Sarrus/Beltrak/README.md

Beltrak
=======

Hornby trainset automation.

My first ever sizable coding project.

Controls a Hornby trainset. Might be useful in a somewhat bizarre set of circumstances.
