Sarrus/Beltrak/the missing page.docx

| GCE Computing

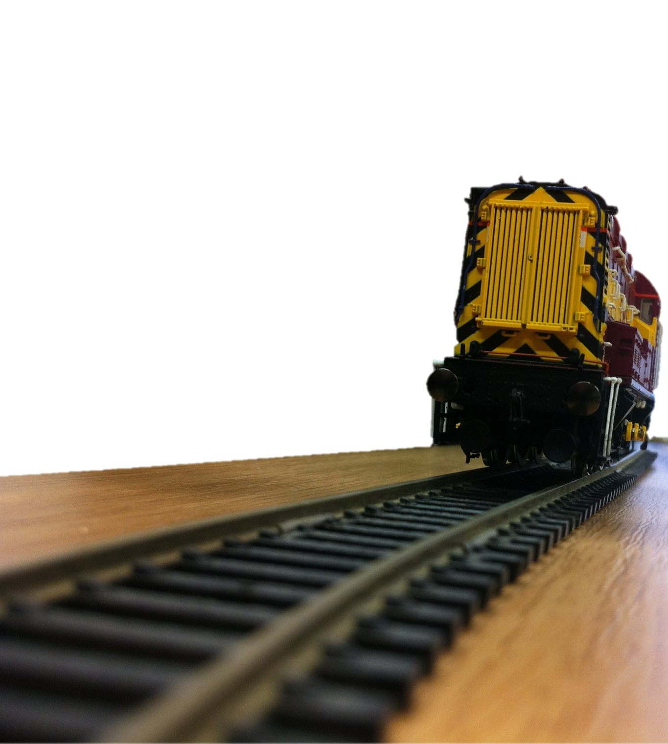
[picture p7: figure]

| Doverbroeck’s Colage 62315 Michael R. Bell 7894

[Beltrac]

Model railway automation.

# Evaluation of the User’s Response to the system

Having read the questionnaire on page 107 I am extremely pleased with his response, his smiley faces and his adding out of bounds answers (positively of course) to the amusement section have made me extremely pleased!

From what he has said I can gather that he Is pleased with the project and it amuses him but it could look better.

While the project is finished my next objective would be to improve the aesthetics of the track, possibly by recruiting the help of someone with taste.

BeltracMichael Bell111/113
