Sarrus/Beltrak/project writeup backups/Project writeup backup 1.docx

| GCE Computing


| Doverbroeck’s Colage 62315 Michael R. Bell 7894

[Beltrac]

Model railway automation.

# definition, investigation and Analasis

# Definition – nature of the problem to be investigated

## the end user

The project is being produced for John Peter Thomas, the owner of a small computer company. In his own words, this is a brief description of his company:

The company is a lifestyle company, i.e. we keep it relatively small, we enjoy our work and we're driven more by the quality of the work we're offered rather than the money. That said, we've recently grown a little to 10 developers who work on a range of bespoke projects for a wide variety of clients. We started out writing code for embedded systems, but have more recently specialised in code for web applications and mobile platforms. We've written primarily for the iPhone, but more recently we've been looking at Android apps. On occasion we are asked to develop full blown web sites, though we have tried to stay away from these as much as possible. We've recently employed a graphics designer for the first time and will most likely take on more web based projects as time moves on.

We've taken on projects for students from d'Overbroecks in the past and without exception have been really pleased with the results. I'm looking forward to seeing a preliminary requirements specification soon.

## the problem

Mr Thomas has a lobby where people wait before meeting him, as this would be where potential clients would find themselves waiting for meetings with him and his staff it would be good to have something to entertain potential clients while they wait, which at the moment they don’t have.

Providing something interesting to entertain has several advantages:

- It prevents potential clients from getting bored and so keeps their mood light for the meeting ahead which can increase the chances of success
- It can display what the company is capable of or, if not created by the company, can imply an ability to produce similar things or an interest in the particular subject matter. Again, this can increase the chances of a deal being struck as well as providing ideas for alternative products

## resources provided

In terms of what Mr. Thomas is willing to provide me it would really just be some floor space and a power supply to use, being England this would be 230~240V(rms) at 50Hz

## further steps

Having gathered a bit of information I arranged a meeting with Mr Thomas, in conversation I asked him some questions about the project, I noted down some basic points based on the responses to the questions:

- We decided to call the project Beltrac
- Beltrak will be on a static platform (no wheels)
- Beltrak will be a loop
- Beltrak will have a cleaning train which dusts the track when switched on
- Beltrak will have a standard train which can be controlled
- Beltrak will have a small display with a simple menu system
- Beltrak will have automated points that can change to navigate the trainto its destination
- Beltrak will have sensors on the track to detect the location of the train
- Beltrak will have an integrated cuircuit breaker to protect the train from surges and from the control board supplying to much current
- Beltrak will have an easy to use interface that requires no pre instruction (though a manual will be provided

Of course, this alone is not enough to create a requirement specification but the information discussed is a good start as well as an opertunity to get to know Mr Thomas a bit better.

# Investigation and analysis

## asertaining the user requirements

### Talking to the user

To begin the whole project process I began by emailing mr. Thomas with a brief explanation of what I am looking to do:

Dear MR Thomas,

I am an A-level student looking to produce a computing project, I am aware that this may not be the first time you have received a request like this, as my teacher Alan informs me that you often act as a client for projects, despite this I hope you will be willing to review my proposal as I am confident in its merit, particularly to someone with such a vast appreciation of complicated electronic nick-nacks.

Did you ever play with Hornby or some other brand of model railway as a kid? Because I sure did! It was a good, carefree time in my life. my proposal is there for an attempt to revive the former, stress relieving, glory by attempting to attach the subtle science of railway signalling to something on a smaller scale by creating a railway that would be safe enough to automatically carry passengers from A to B with minimal loss of limbs.

In principal it would be a similar model to that of the docklands light railway, that is, a train controlled by a computer off the train, using data gathered from the tracks about the location of the train and other obstacles, with the advantage of not actually carrying passengers which eliminates the necessity for a member of railway staff on hand to unjam passengers from the doors (of course the dispatch panel on board the train could be simulated externally for the full experience).

you are probably wandering what this project could possibly do for you but picture this, the world industry is changing, for all you know your company may go into "railway related work" someday and it would certainly be swell to have a fully automated model railway to entertain waiting clients

Should you have any questions I would be happy to indulge them,

Michael Bell

His 1st reply was:

Hello Michael

Alan did tell me that you had a project that you'd like to do. As Alan probably told you we do like to display interesting projects in our entrance area and I've been very happy to showcase student projects before so your project definitely does interest me. A working train set in the office would definitely draw some interest especially if it has a significant control component.

What sort of control hardware do you have in mind? There's a lot of buzz these days about the Raspberry Pi which is an excellent piece of kit but I suspect that you should consider something more dedicated to control such as the Arduino range of boards. They're programmable in C and have a wide range of analog and digital inputs and outputs.

Alan has asked me to look at one of his other students' projects this year too - perhaps the two of you could get together and come down to meet us some time in the next week or so.

Cheers

-John

After this we began an exchange in which I sent mr. Thomas a series of questions and he replied with answers to each question, though not the original format, for readability I have separated out each question and the responses given to it. My questions / responses are written in Lilac and mr thomas’s are written in brown,

- Would you like an interface to control the train and if so what would be your preference on what it is? LCD, computer program etc.
  - An LCD interface is fine, how many characters? how many lines? colour or b&w?
    - It would have 2 lines probably about 20 chars each
      - That's fine, but you'll need to specify exactly what's going to appear on each of the lines. I suggest for simplicity that you try to adopt a menu structure, but maybe you have other ideas.
        - No, a menu structure sounds good to me
  - A standard PC computer interface would also be great - you might find it sensible in your development to build a PC interface simply to provide yourself with a simple easy to change interface. Programming LCD displays is often trickier. But, clearly we'll need some sort of user interface in the final version and an LCD interface would be fine, assuming of course that its comprehensive and ideally intuitive. We'd like our visitors to be able to play with it when they're waiting for us and it needs to be self explanatory if that's going to work.
    - The lcd i had in mind is quite easy to program, it is designed specificaly for the arduino board and operating it is as easy as sending it a string of text
      - Sounds good - is it colour?
        - No its just 2 lines of black and white characters
  - Clearly we need to agree on what the user interface is going to allow us to do - that will require quite a bit of discussion.
    - I know you want it to allow selection of a destination, and to initiate the cleaning train, what else would you like it to do?
- The track needs to be cleaned regularly as dust can damage the trains, would you like to clean it yourself or have a second train that cleans the track at regular intervals?
  - A secondary train is an excellent idea. Perhaps it could appear at various intervals ? It would be nice to control this from the user interface, i.e. set intervals, initiate cleaning and so on.
    - Thats fine though i should say that the abrasive pads on the bottom of the train must be changed by hand when they get clogged up with dust
      - OK - that's something that we can organise on a regular basis.
- Would you like the train system to turn itself on and off at set times? Eg. Running only during office hours
  - An automatic mode is an excellent idea - again a variety of scenarios chosen from the user interface would be good.
- Would you like the primary train to (in automatic mode) run itself to a scedual or pick stations at random
  - Both, set by the user interface.
- How many stops would you like?
  - How many can we have ?
    - I would say about 5 would be a good idea
      - OK.
- Would you like the trains to move relitivly quickly or slowly?
  - Various speeds - sometimes fast, sometimes slow, again set by the user interface - scripted would be good.
    - Ok i will
- Would you like electronic signals on the track? Eg. Lights, semaphores etc.
  - Definitely.
  - Can I please see some diagrams of how you're planning on laying out the track? Do you have any photographs? It would be good to get a really good idea of how big and complicated the system is.
    - I will have lots of time to do that this weekend
      - Could I see some please.
        - I will send you some pictures ASAP
  - What are your thoughts on user interface functionality?
    - I think that there should be a manual and automatic mode, the modes could be switched by a switch or a key, in automatic mode the screen displays the name of the prgram on the top line and what the train is currently doing eg. "Awaiting Right Ahead" or "slowing for stop in block 1"
    - In manual mode the program would have a simple menu struture allowing options like, setting what the train does in automatic mode, picking the next station for the train to reach, initiating cleaning, setting on and off times and checking that the track is clear.
    - When in automatic mode, customers could interface with the train using large colourful iluminated buttons rather than a booreing looking lcd display with options like "go" "stop now" "stop at next station" etc.
      - That sounds fine.
  - What are you planning to use as your control hardware? I know that Leo is thinking seriously about using an arduino board - are you going down the same route or do you have some alternatives in mind ?
    - Same route

During this conversation mr Thomas requested some pictures of a basic track layout and the train so I captured these images and sent them to him:

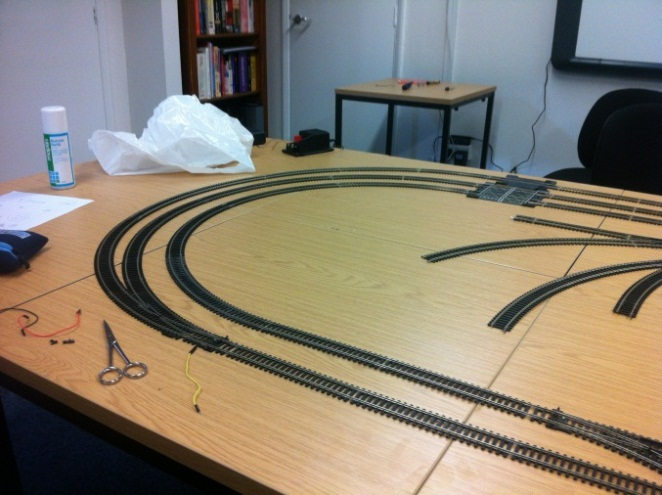
[picture p8: figure]
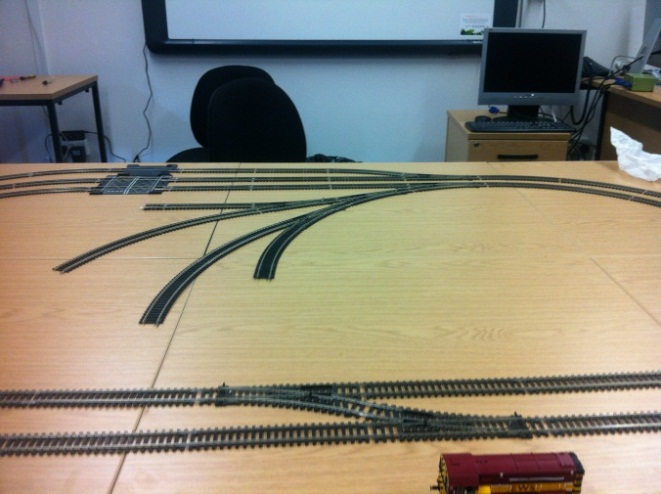
[picture p9: figure]
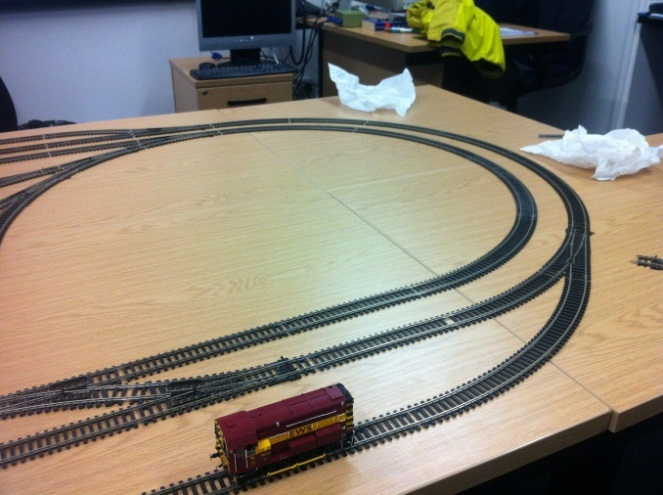
[picture p10: figure]
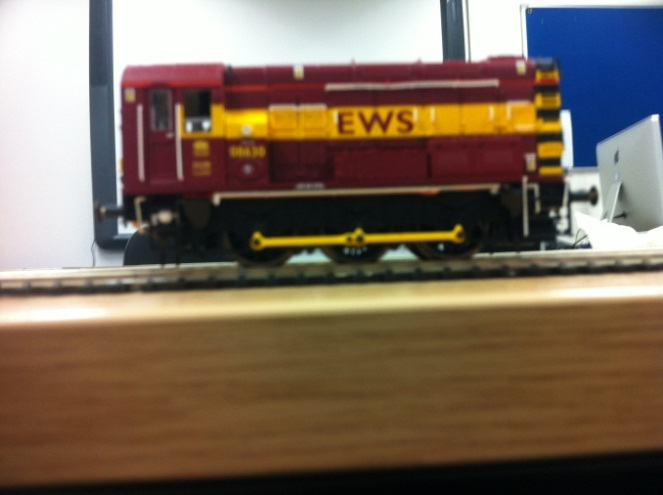
[picture p11: figure]
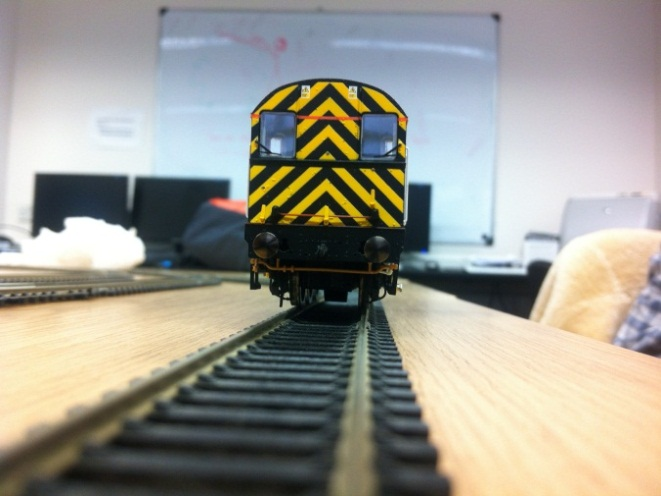
[picture p12: figure]

This was his response:

Thanks for these - I assume that the image of the track is the track you'd like to use. If so, it looks good but I'd like to understand what functionality you are thinking of including. By which I mean things like,

what is the function of the `orphan' pieces in the centre?

how many sensors are you planning on using?

how many points are there in total ? presumably you're intending to control the movement of the train by modifying the position of the points and controlling the speed and the direction of the train - that should do everything you want.

You mentioned a `cleaning' train. Presumably that will sit somewhere off the main track and move out into the central section when required, at which point presumably the train itself will have to move elsewhere - all of which will again presumably be under microprocessor control?

In order to understand exactly what you're proposing, I really would like to see a reasonably complete description of the functionality of the entire operation of the train line. Can you get this to me fairly soon so that we can internally make a final decision on whether the project is interesting enough to take up some of our foyer space.

Thanks

-John

## requirements specification

### 1.0

#### user requirements

1. The user should be able to select a manual or automatic mode
  a. In manual mode the next destination of the train can be chosen
  b. In automatic mode the train goes to either random or sequential stations until stoped
2. The user should be presented with a simple display that can be controlled using directional arrows and a confirm button

#### hardware requirements

1. there should be a small train (00 gague) which is controlled by a microcontroller with the user interfase attached
2. the train should travel at multiple speeds and stop at multiple stations with points used to provide multiple possible routes
3. sensors on the track or the train should detect its location and this information should be used to manuver the train
4. the maximum voltage of the train should never be exceded
5. the train should appear to gain or loose speed smoothly
6. the tracks should be able to isolate a sideing so that the train on it can be held, allowing a different train a turn on the tracks
7. the train should be able to travel forwards and backwards at equal maximum speeds
8. the layout should be designed that if the train is moved forward that no mater where it is it will always trigger a sensor on its journey
9. failsafes such as circuit breakers should be in place to protect the train and the equipment

#### software requirements

1. The microcontroller should be able to recognise the location of the train and act accordingly
2. It should anticipate the possibility that a sensor has failed and should be able to act if the sensors are not called in sequence
3. The software should be able to plot a route from any station to any station
4. The software should be able to activate a cleaning train at any time to clean all the tracks and it should be able to manage the activation of both this and the main train by isolating sidings
5. The software should be able to reacertain the location of the train in case of a power failure by moveing it forward untill it trigures a sensor
6. The software must not perform any actions that could damage the train or any other equipment

BeltracMichael Bell6/9
