Sarrus/Beltrak/foil block.pdf

# BELTRAC

HORNBY TRAIN SET AUTOMATION

Michael Bell
