Sarrus/Beltrak/designs/track design 1 potentialy different isolatable track.png

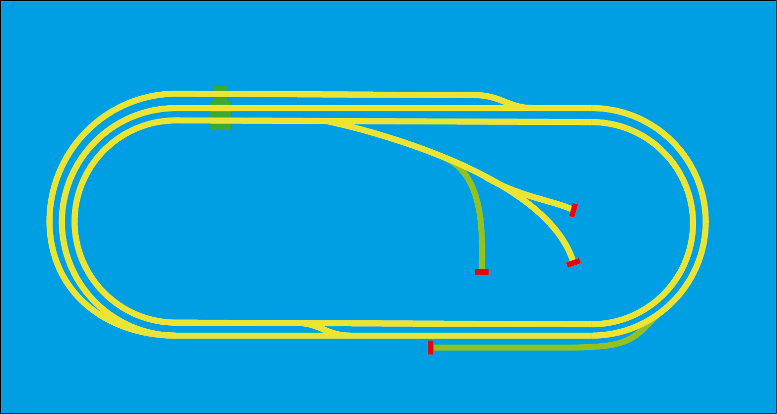
designs/track design 1 potentialy different isolatable track.png
