Sarrus/Beltrak/designs/track design 1 potentialy different with sensors positioned.png

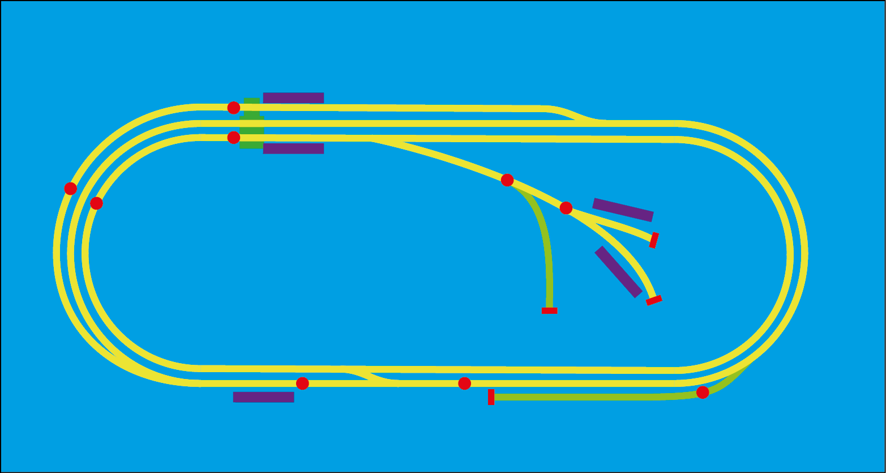
designs/track design 1 potentialy different with sensors positioned.png
