Sarrus/Beltrak/pictures/real world examples/Rail_treadle.jpg

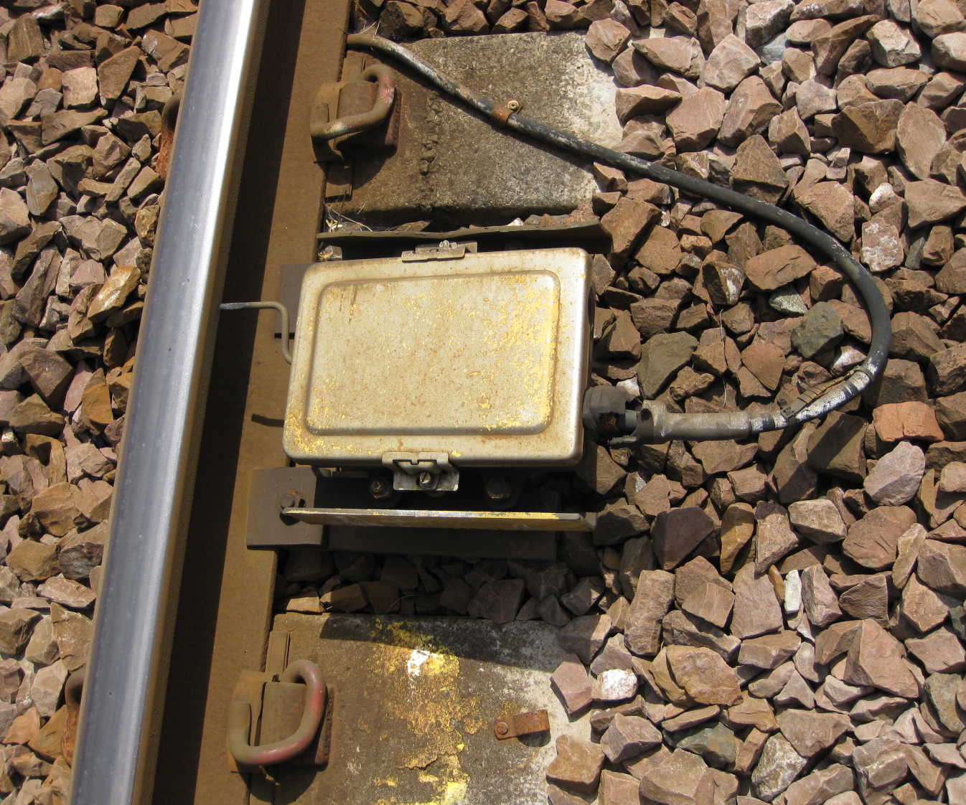
pictures/real world examples/Rail_treadle.jpg
