Sarrus/Beltrak/pictures/tittle pages/4437422182_d478fc9a82_o.jpg

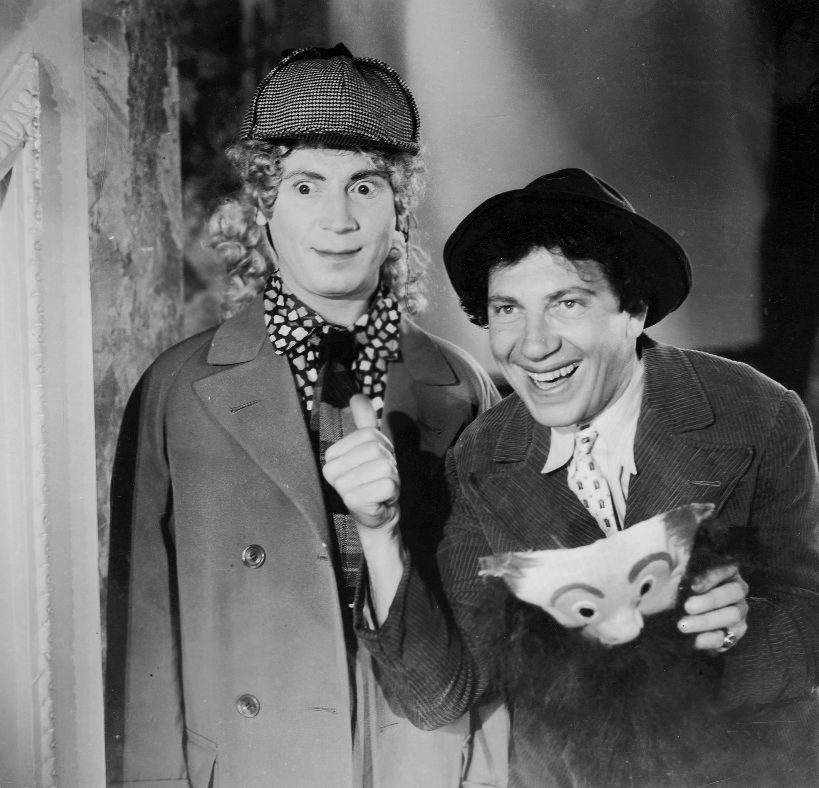
pictures/tittle pages/4437422182_d478fc9a82_o.jpg
