Sarrus/Beltrak/pictures/tittle pages/peter-sellers-trenchcoat.jpg

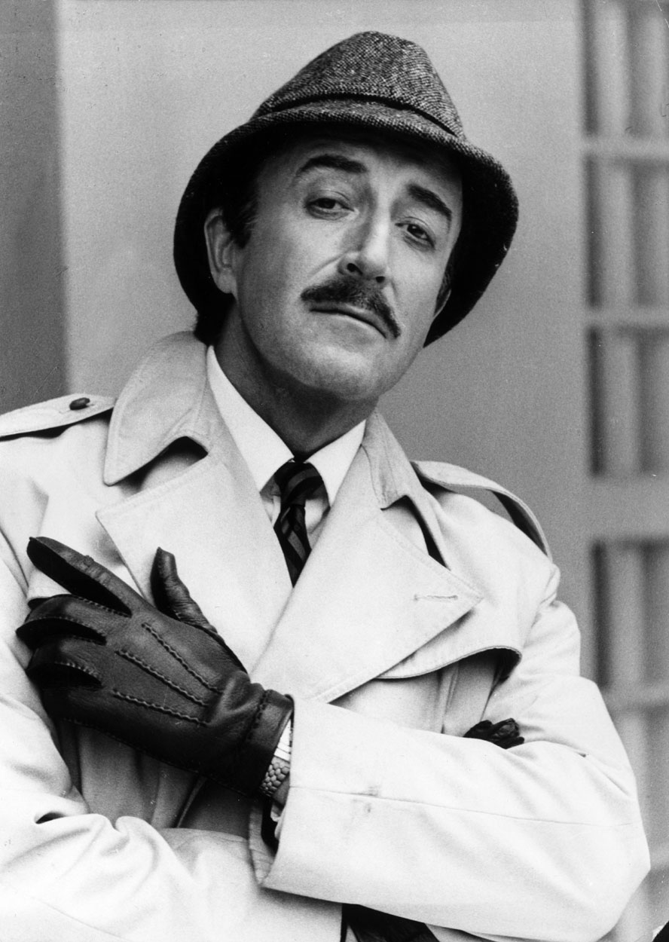
pictures/tittle pages/peter-sellers-trenchcoat.jpg
