Sarrus/Beltrak/pictures/track design/-neodymium-magnet-0.72kg-pull-x25-a28-y--147-p.jpg

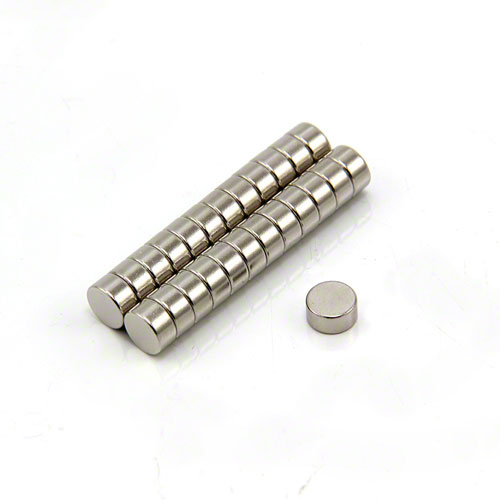
pictures/track design/-neodymium-magnet-0.72kg-pull-x25-a28-y--147-p.jpg
