Sarrus/Beltrak/Requirement specifications/track design 1.png

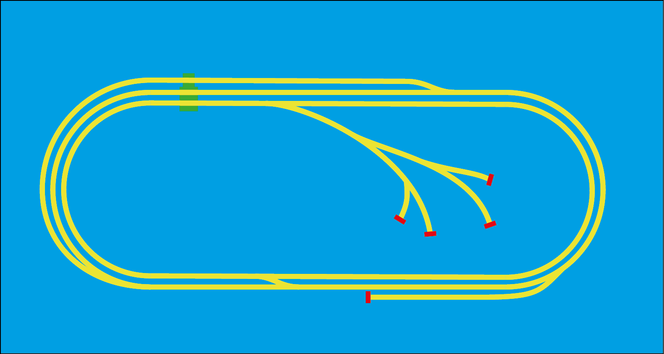
Requirement specifications/track design 1.png
