Sarrus/Beltrak/pictures/hall effect testing/Photo 04-12-2012 10 16 29.jpg

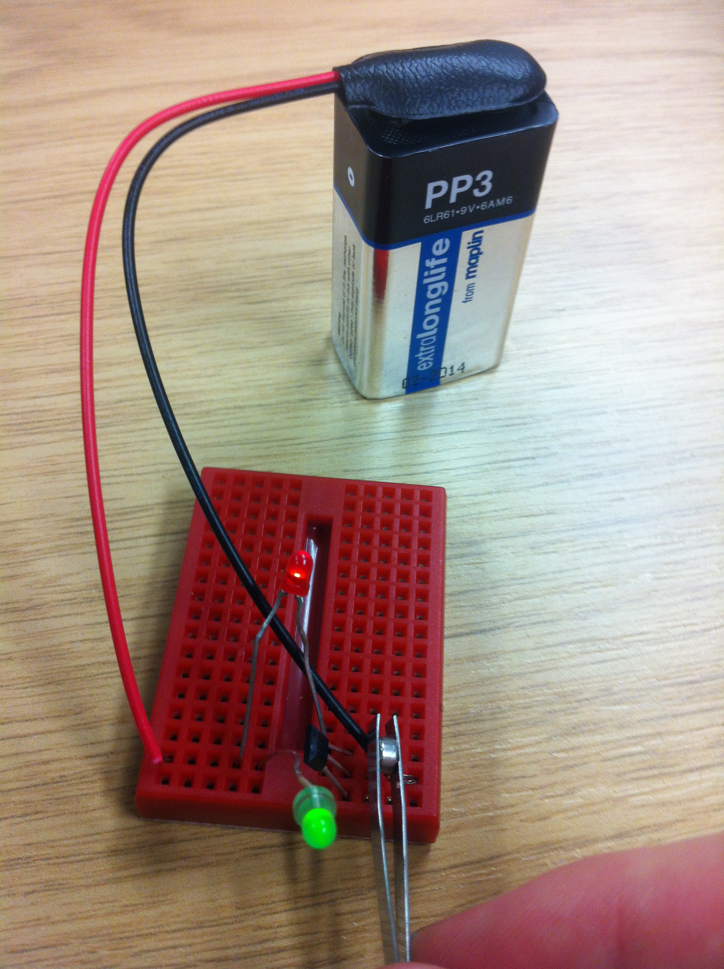
pictures/hall effect testing/Photo 04-12-2012 10 16 29.jpg
