Sarrus/Beltrak/pictures/motor testing/Photo 20-11-2012 10 43 38.jpg

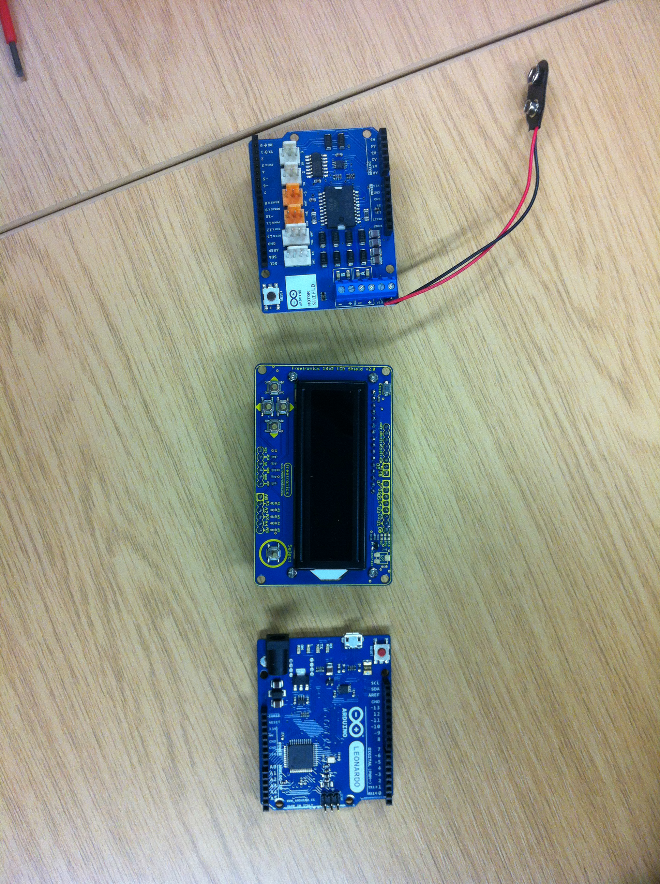
pictures/motor testing/Photo 20-11-2012 10 43 38.jpg
