Sarrus/Beltrak/pictures/motor testing/Photo 20-11-2012 10 45 24.jpg

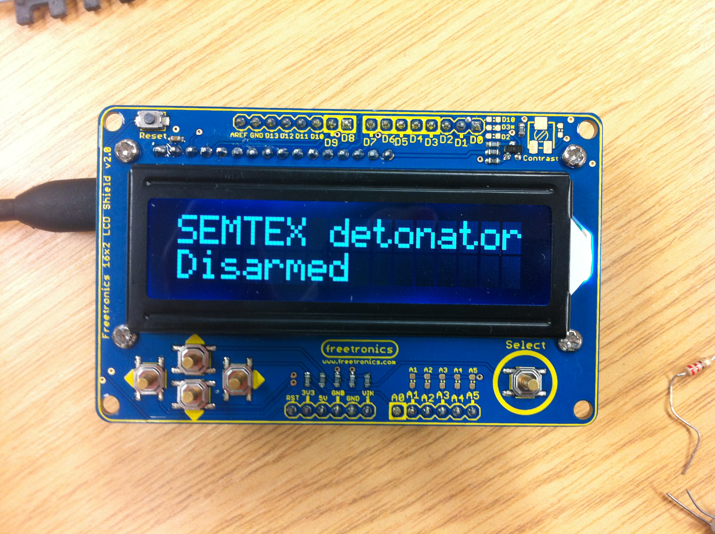
pictures/motor testing/Photo 20-11-2012 10 45 24.jpg
