Sarrus/Beltrak/pictures/motor testing/Photo 20-11-2012 10 46 00.jpg

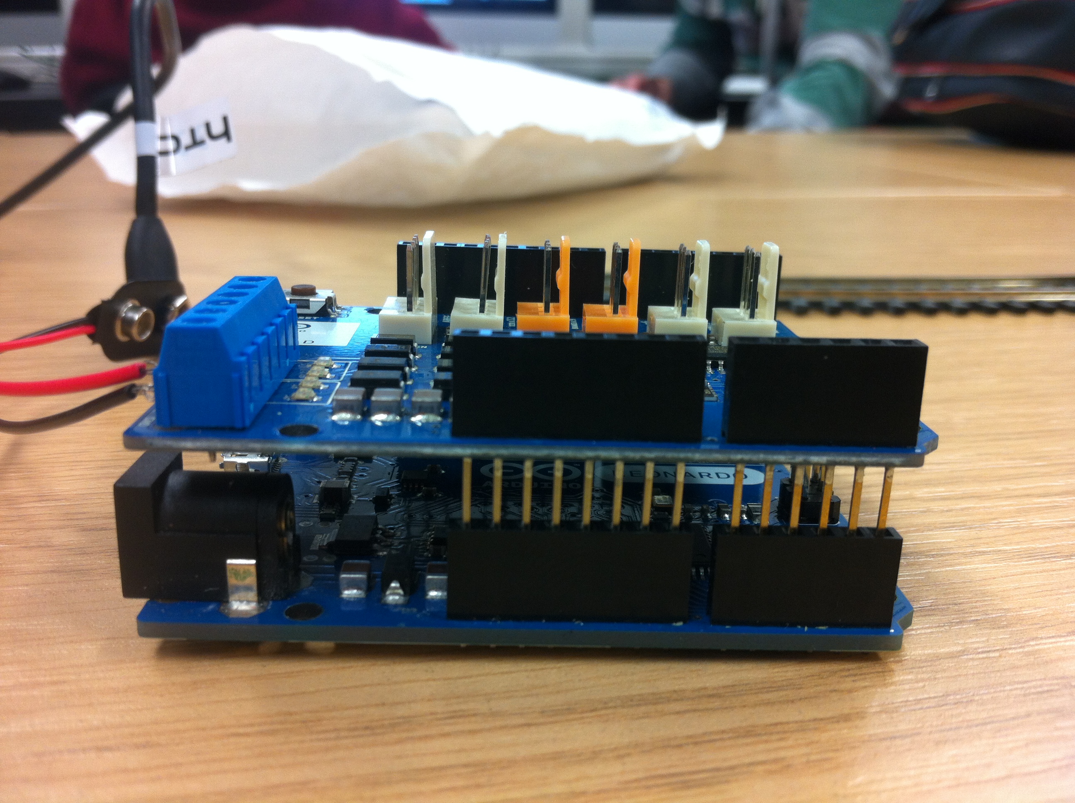
pictures/motor testing/Photo 20-11-2012 10 46 00.jpg
