Sarrus/Beltrak/pictures/motor testing/Photo 20-11-2012 10 48 46.jpg

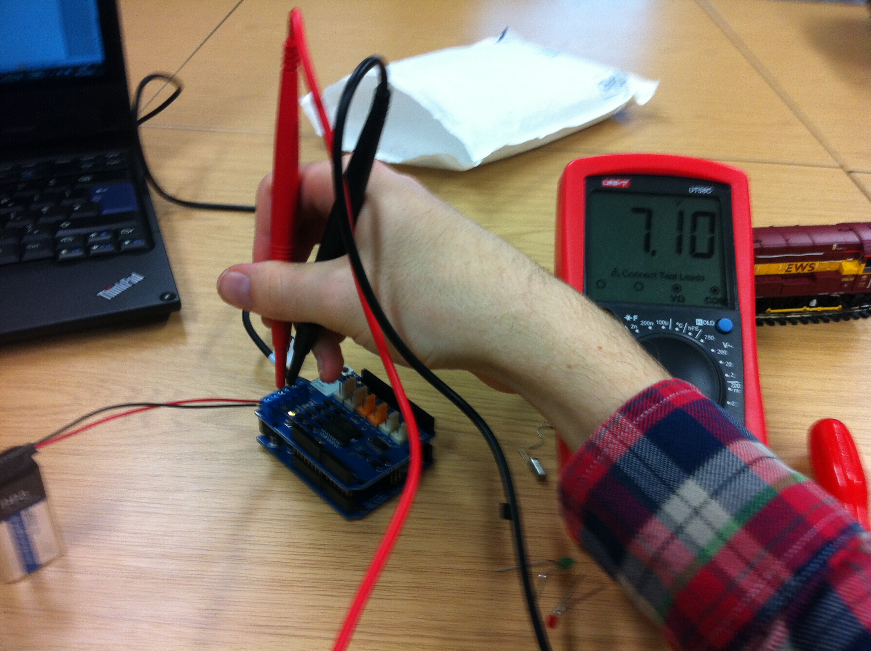
pictures/motor testing/Photo 20-11-2012 10 48 46.jpg
