Sarrus/Beltrak/pictures/track testing/Photo 01-10-2012 09 50 00.jpg

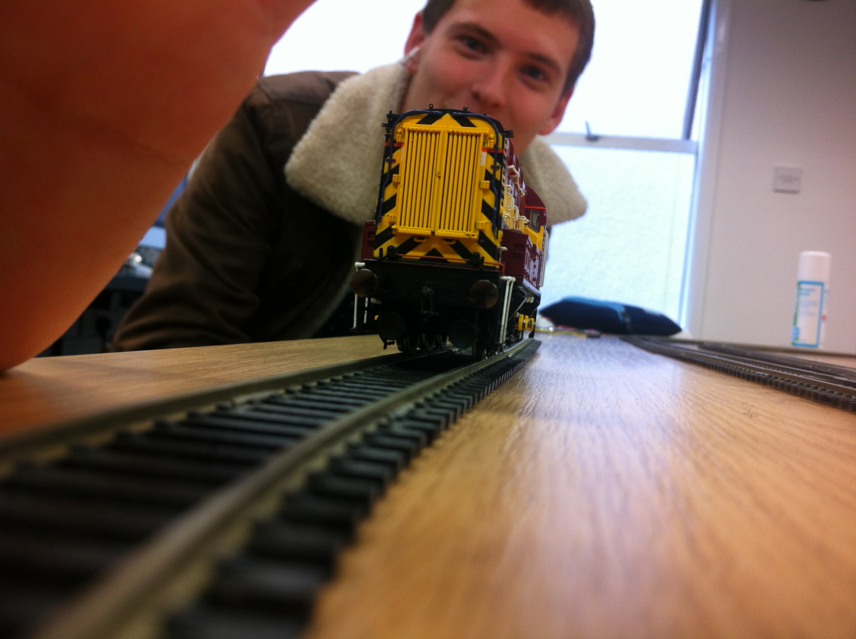
pictures/track testing/Photo 01-10-2012 09 50 00.jpg
