Sarrus/Beltrak/pictures/track design/standard anticlockwise forward sensor problem.png

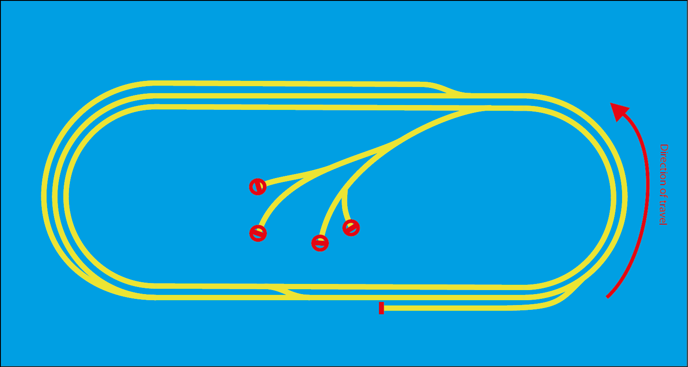
pictures/track design/standard anticlockwise forward sensor problem.png
