Sarrus/Beltrak/designs/menu example.pdf

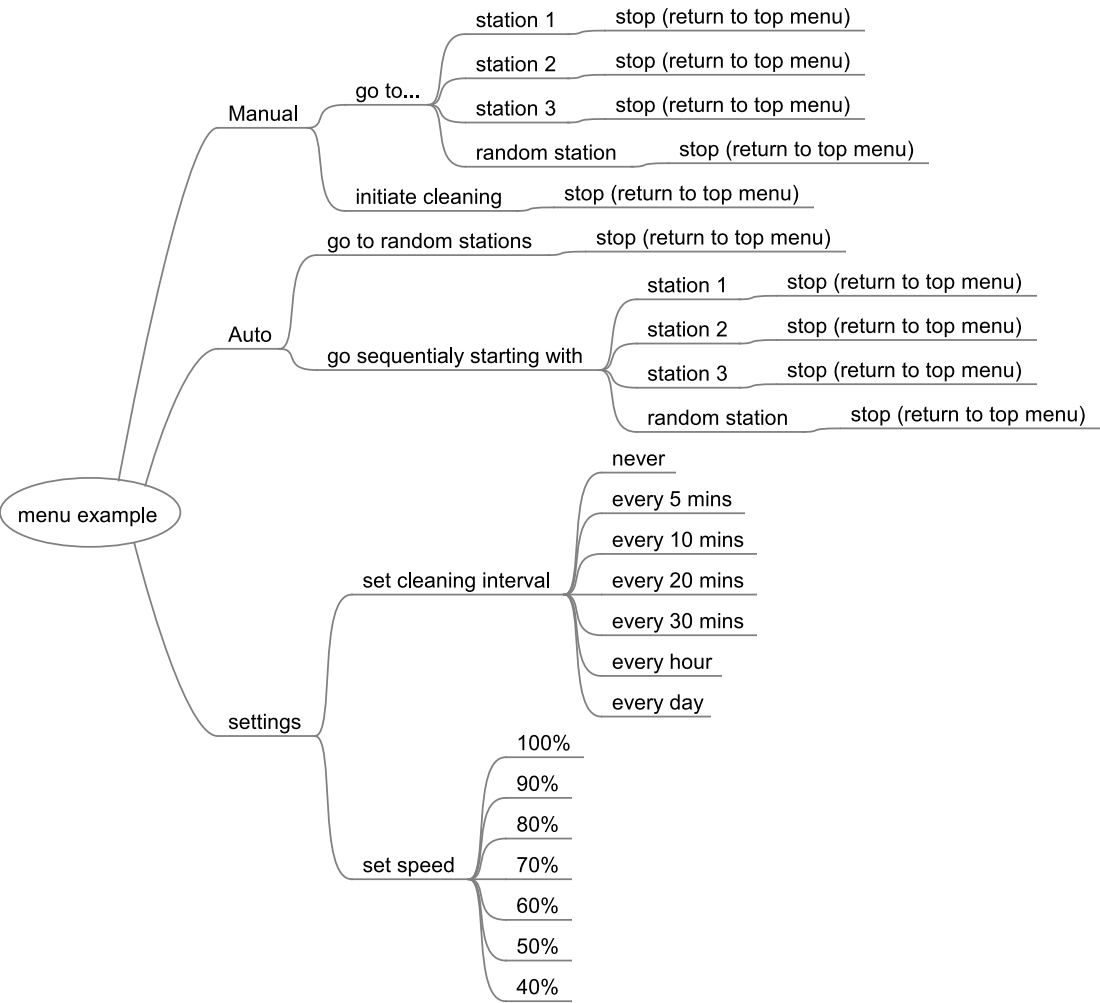
[picture p54: page 1]
