Sarrus/Beltrak/Beltrak/beltrak/checkPoints.ino

/*

 BELTRAK
 
 V1.0
 
 Hornby trainset automation
 
 By Michael Bell
 
 Programing started: 02/02/2013 at 14:08
 
 Programing completed: 06/05/2013 at 17:45
 
 */

/*this function was originaly used to check the position of the points but it turned out
to cause multiple errors and so was removed and replaced with code that simply switched 
the points without remembering their position*/


void checkPoints()
{
//  for (int i = 1; i < 11; i++)  //goes through all the points
//  {
//    if (pointState[i] != pointSwitch[i]) //if the state doesent match what it should be
//    {
//      setPoint(pointSwitch[i], i); //move the points
//      pointState[i] = pointSwitch[i]; //change the state
//    }
//  }
}
