Sarrus/Beltrak/Beltrak/beltrak/outputToTrack.ino

/*

 BELTRAK
 
 V1.0
 
 Hornby trainset automation
 
 By Michael Bell
 
 Programing started: 02/02/2013 at 14:08
 
 Programing completed: 06/05/2013 at 17:45
 
 */

void outputToTrack()
{
  
  //set the points
  //checkPoints();

  //apply the PPD to the train
  analogWrite(pinPD, int((PPD / 100) * 255));

  //apply the reverser to the train
  if (reverser)
  {
    digitalWrite(pinDIR, HIGH);//if this is high the train travels backwards
  }
  else
  {
    digitalWrite(pinDIR, LOW);
  }


}
