Sarrus/Beltrak/(commit log)

2012-12-15 Added track circuits and hall effect switches
2012-12-15 Added Magnet choice
2012-12-15 added more to magnet choice
2013-01-07 Decided the position of the sensors and platforms
2013-01-08 sensor position image has highlighted sidings
2013-01-08 captioned sensor positions
2013-01-21 added switching conditions
2013-01-21 created overall process flowchart
2013-01-25 inserted button processing algoritm
2013-01-25 inserted position check
2013-01-27 created switch state
2013-01-27 created trial 1 of switch state
2013-01-29 updated switch states to read A0 correctly
    to simplify the code > switches state rather than enter
    [switch_state.ino]
2013-02-02 started beltrak
    compiled to check placeholders
2013-02-02 Revert "started beltrak"
    This reverts commit 5cb620b93e8fb2969a75e555071db276360a0b64.
2013-02-02 fixed compile issue
    sketches cannot be named main, no warning given
    [beltrak.ino]
2013-02-03 created function to output speed to the train
    tested by uploading to the board and reading output A motor pins with
    voltmeter
2013-02-03 added missing comments
    compiled to check for uncomented text
    [beltrak.ino]
2013-02-03 added the first sensor reading and speed setting
    compiled after typeing each line, also created a testing array to
    simulate a setting input and a virtual sensor in the form of a boolean
    to simulate a sensor, the code was sent to the board with the
    instructions preset and a serial console was used to test when it
    elected that the conditions where met, after this a volt meter was used
    to test weather or not the PPD was changed when instructed to do so
2013-02-03 added wait function
    tested with test instruction, volt meter whent from 0 to 11 when timer
    had passed
2013-02-03 added converge and diverge instructions
    tested by providing the board with preset instructions and printing the
    contence of the points array
2013-02-03 part completed button input programing
2013-02-03 completed button outputs
2013-02-04 changed the PPD of half speed settings to bigger
    50 is too slow and sometimes the train wont start 75 seems to work
    better
    [beltrak.ino]
2013-02-10 put output to track in its own function
2013-02-15 added control of 3 relays
2013-02-15 added hash responder
    ran on board and tabbed through menu to test
2013-02-15 have the board folowing consecutive instructions
2013-03-13 added pin mappings
2013-03-13 made compatable with big relay
2013-03-14 added the sensor numbers
2013-03-14 made button reader able to read sensors as well
2013-03-14 defined the sensor pins
2013-03-19 added the beltrak fonts
2013-03-25 started point motors
2013-03-25 added to point motors
2013-03-29 started point relay diagram
2013-04-01 setup instructions to test inplimented sensor
2013-04-01 added the hall effect data sheet
2013-04-06 completed point relays 1.0
2013-04-06 added second point relay version
2013-04-06 added third point relay version
2013-04-06 drew out the inside of a point motor
2013-04-06 added the design with diodes included
2013-05-04 fixed transformer issue
    point dir relay is powered off after setting a point
    [setPoint.ino]
